peregrine-developments/STACY/README.md

# STACY
Requires symbols/footprints from [TheBoisCollective global library ](https://github.com/peregrine-developments/TBC_Global)
