peregrine-developments/STACY/mounts/GPS Mount.3mf

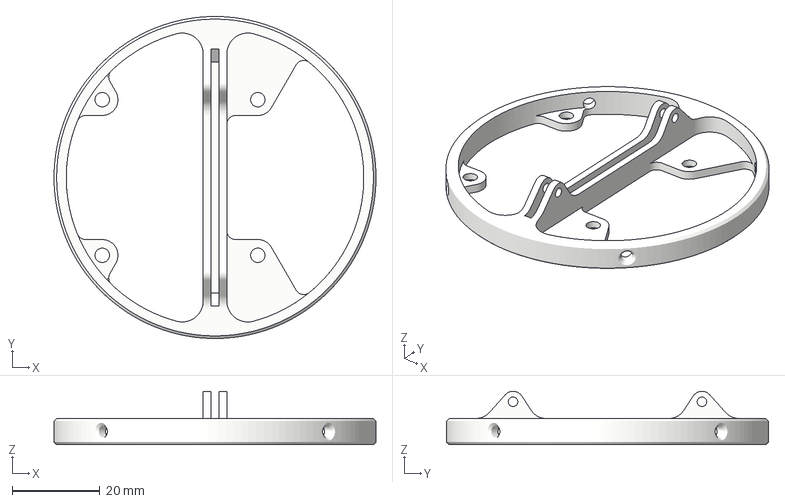
[picture p1: CAD file, 2022-02-06]
mounts/GPS Mount.3mf
73.6 x 73.6 x 12.2 mm
