peregrine-developments/STACY/mounts/Battery Mount.3mf

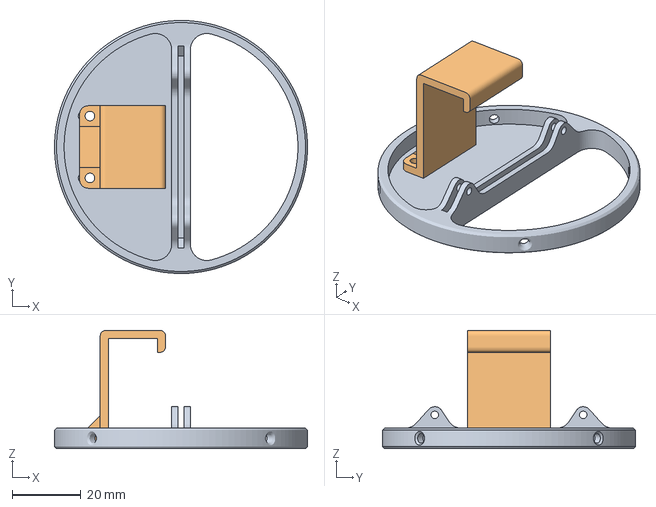
[picture p2: CAD file, 2022-02-06]
mounts/Battery Mount.3mf
73.6 x 73.6 x 34.4 mm
