peregrine-developments/STACY/mounts/Base Mount.3mf

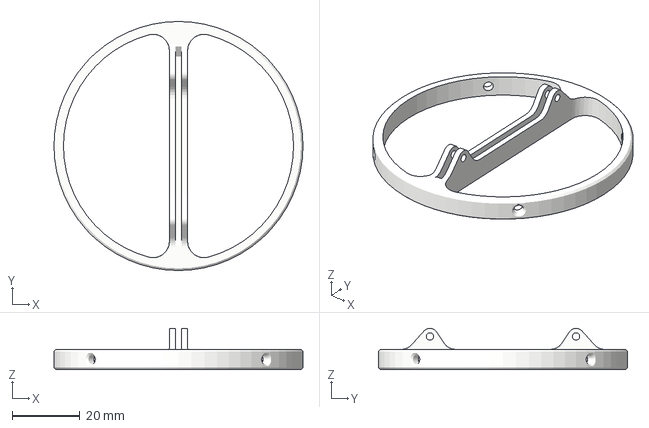
[picture p3: CAD file, 2022-02-06]
mounts/Base Mount.3mf
73.6 x 73.6 x 12.2 mm
