peregrine-developments/STACY/mounts/Bulkhead Mount.3mf

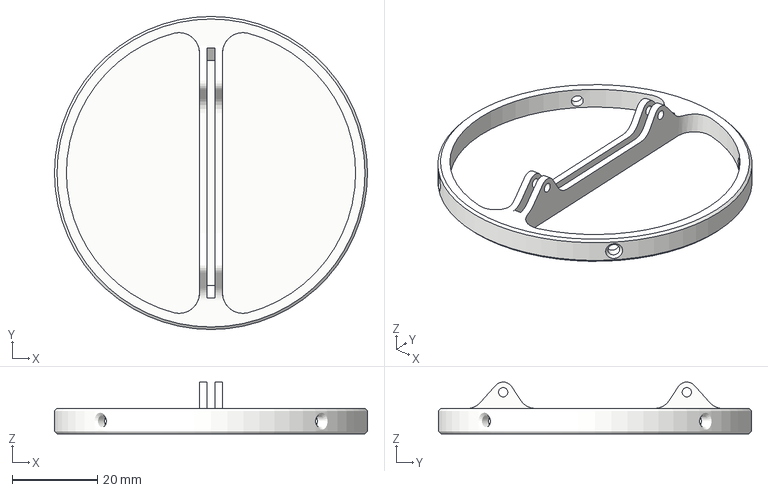
[picture p4: CAD file, 2022-02-06]
mounts/Bulkhead Mount.3mf
73.6 x 73.6 x 12.2 mm
