peregrine-developments/STACY/allfc/allfc.kicad_pcb

## KiCad design allfc/allfc.kicad_pcb (2021-08-03)

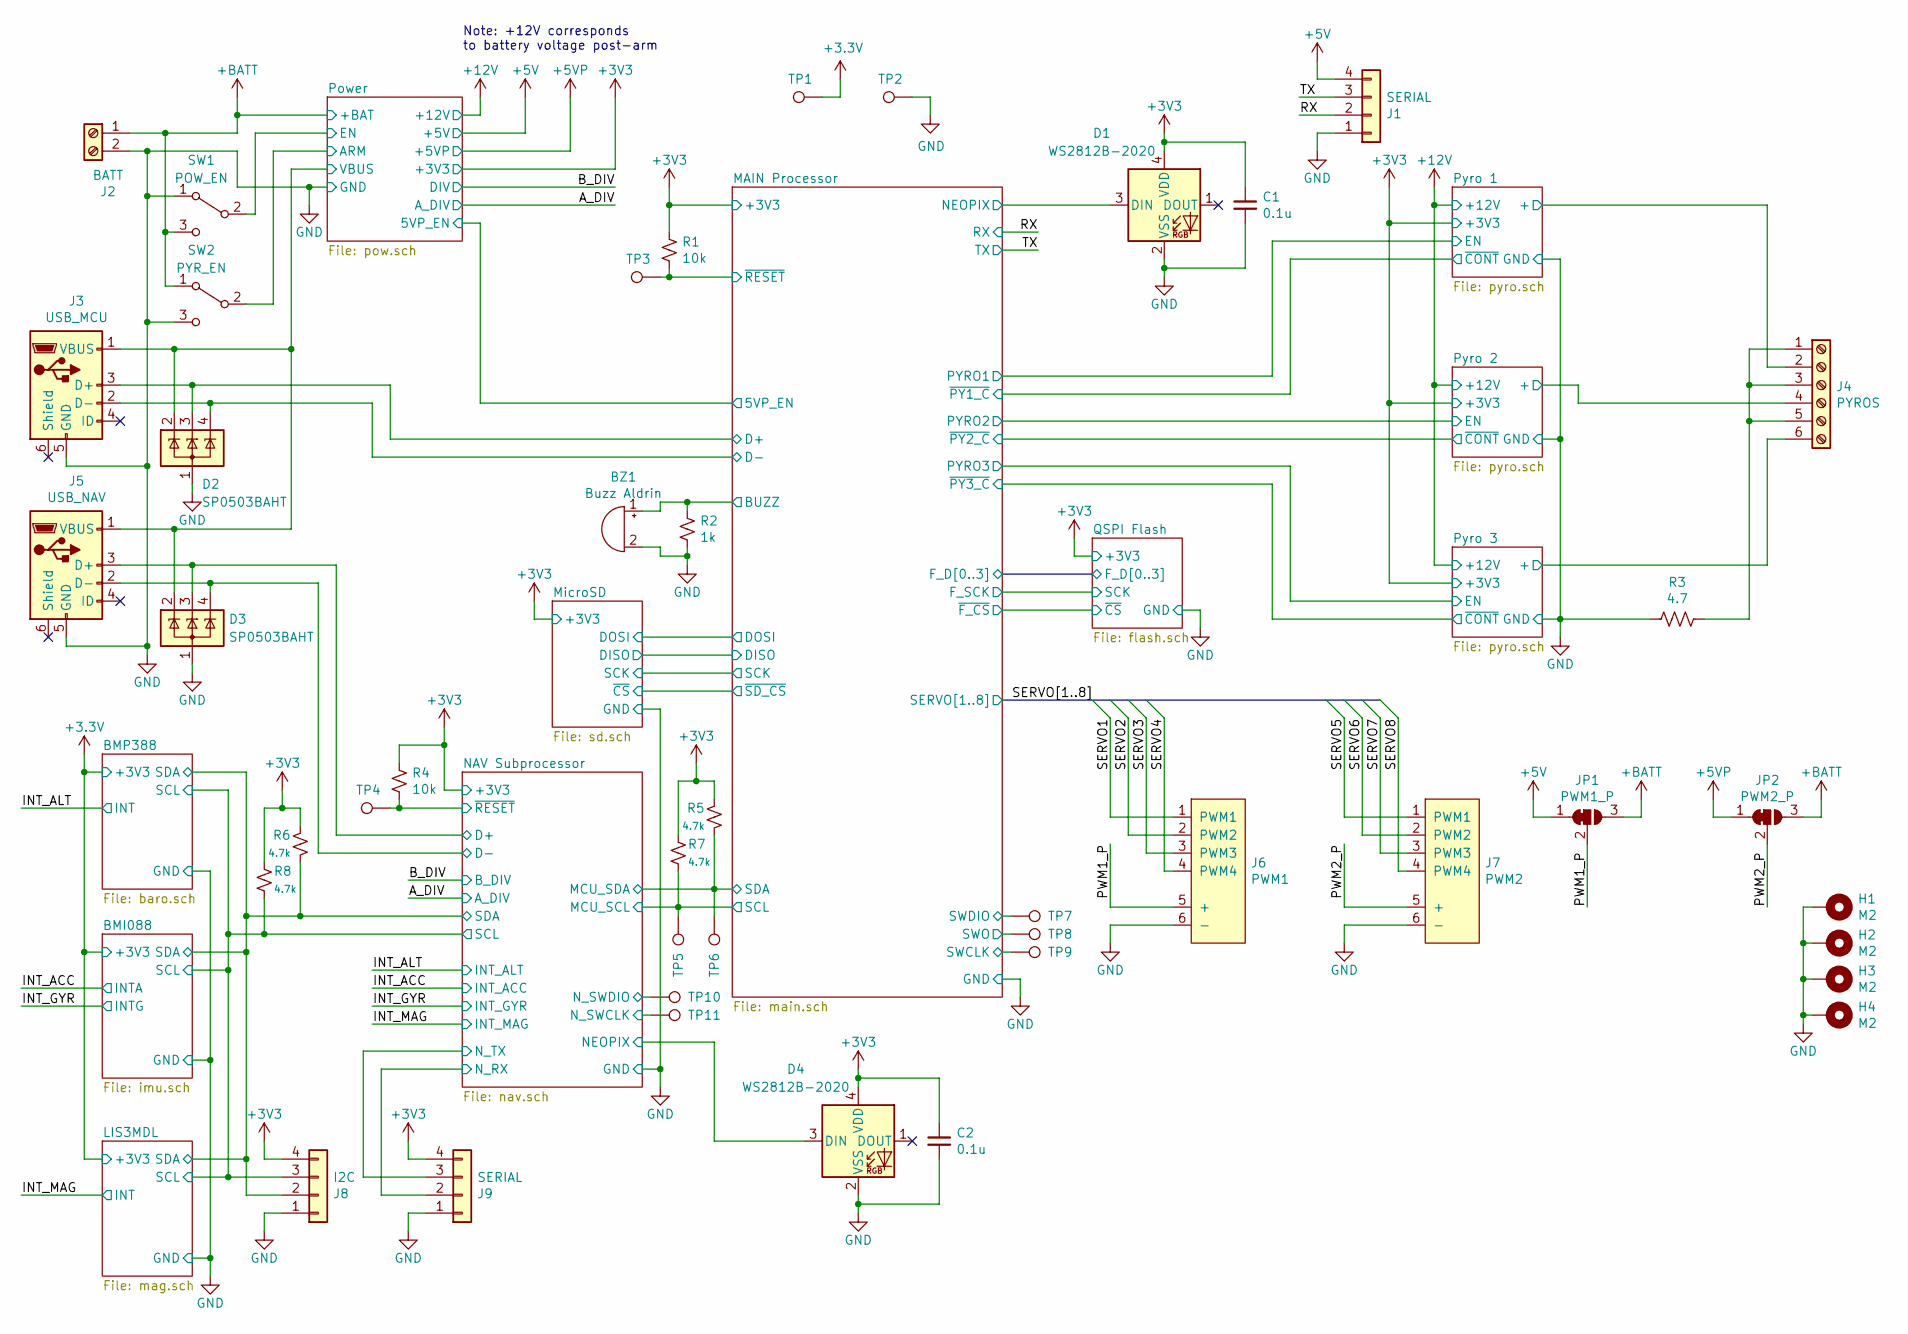
[picture p50: schematic allfc.sch, CUC - Overview]

Parts:
BZ1: Buzz Aldrin; Buzzer_CUI_CPT-9019S-SMT
C1, C2: 0.1u; C_0603_1608Metric
D1, D4: WS2812B-2020; WS2812B-2020_2x2mm
D2, D3: SP0503BAHT; SOT-143
H1, H2, H3, H4: M2; MountingHole_2.2mm_M2_Pad
J1, J9: SERIAL; JST_GH_BM04B-GHS-TBT_1x04-1MP_P1.25mm_Vertical
J2: BATT; TerminalBlock_Phoenix_MKDS-3-2-5.08_1x02_P5.08mm_Horizontal
J3: USB_MCU; USB_Micro-B_Molex_47346-0001_ShieldFloat
J4: PYROS; TerminalBlock_Phoenix_MKDS-3-6-5.08_1x06_P5.08mm_Horizontal
J5: USB_NAV; USB_Micro-B_Molex_47346-0001_ShieldFloat
J6: PWM1; PinHeader_3x04_P2.54mm_Vertical
J7: PWM2; PinHeader_3x04_P2.54mm_Vertical
J8: I2C; JST_GH_BM04B-GHS-TBT_1x04-1MP_P1.25mm_Vertical
JP1: PWM1_P; SolderJumper-3_P1.3mm_Bridged12_Pad1.0x1.5mm_NumberLabels
JP2: PWM2_P; SolderJumper-3_P1.3mm_Bridged12_Pad1.0x1.5mm_NumberLabels
R1, R4: 10k; R_0603_1608Metric
R2: 1k; R_0603_1608Metric
R3: 4.7; R_2512_6332Metric
R5, R6, R7, R8: 4.7k; R_0603_1608Metric
SW1: POW_EN; SW_SPDT_PCM12_HIDD
SW2: PYR_EN; SW_SPDT_PCM12_HIDD
TP1, TP2, TP3, TP4, TP5, TP6, TP7, TP8, TP9, TP10, TP11: TestPoint; TestPoint_THTPad_D1.0mm_Drill0.5mm

Connections:
+3V3: C1.1, C2.1, D1.4 (VDD), D4.4 (VDD), J8.4, J9.4, R1.2, R4.2, R5.1, R6.1, R7.1, R8.1, TP1.1; also elsewhere on the board
+5V: J1.4, JP1.1 (A); also elsewhere on the board
+5VP: JP2.1 (A); also elsewhere on the board
+BATT: J2.1, JP1.3 (B), JP2.3 (B), SW1.3 (C), SW2.1 (A); also elsewhere on the board
/BMI088/SCL: J8.3, R8.2; also elsewhere on the board
/BMI088/SDA: J8.2, R6.2; also elsewhere on the board
/MAIN Processor/BUZZ: BZ1.1 (-), R2.1; also elsewhere on the board
/MAIN Processor/D+: D2.3 (K), J3.3 (D+); also elsewhere on the board
/MAIN Processor/D-: D2.4 (K), J3.2 (D-); also elsewhere on the board
/MAIN Processor/NEOPIX: D1.3 (DIN); also elsewhere on the board
/MAIN Processor/SWCLK: TP9.1; also elsewhere on the board
/MAIN Processor/SWDIO: TP7.1; also elsewhere on the board
/MAIN Processor/SWO: TP8.1; also elsewhere on the board
/MAIN Processor/~RESET: R1.1, TP3.1; also elsewhere on the board
/NAV Subprocessor/D+: D3.3 (K), J5.3 (D+); also elsewhere on the board
/NAV Subprocessor/D-: D3.4 (K), J5.2 (D-); also elsewhere on the board
/NAV Subprocessor/MCU_SCL: R7.2, TP5.1; also elsewhere on the board
/NAV Subprocessor/MCU_SDA: R5.2, TP6.1; also elsewhere on the board
/NAV Subprocessor/NEOPIX: D4.3 (DIN); also elsewhere on the board
/NAV Subprocessor/N_RX: J9.2; also elsewhere on the board
/NAV Subprocessor/N_SWCLK: TP11.1; also elsewhere on the board
/NAV Subprocessor/N_SWDIO: TP10.1; also elsewhere on the board
/NAV Subprocessor/N_TX: J9.3; also elsewhere on the board
/NAV Subprocessor/~RESET: R4.1, TP4.1; also elsewhere on the board
/PWM1_P: J6.5 (+), JP1.2 (C)
/PWM2_P: J7.5 (+), JP2.2 (C)
/Power/ARM: SW2.2 (B); also elsewhere on the board
/Power/EN: SW1.2 (B); also elsewhere on the board
/Power/VBUS: D2.2 (K), D3.2 (K), J3.1 (VBUS), J5.1 (VBUS); also elsewhere on the board
/Pyro 1/+: J4.2; also elsewhere on the board
/Pyro 2/+: J4.4; also elsewhere on the board
/Pyro 3/+: J4.6; also elsewhere on the board
/RX: J1.2; also elsewhere on the board
/SERVO1: J6.1 (PWM1); also elsewhere on the board
/SERVO2: J6.2 (PWM2); also elsewhere on the board
/SERVO3: J6.3 (PWM3); also elsewhere on the board
/SERVO4: J6.4 (PWM4); also elsewhere on the board
/SERVO5: J7.1 (PWM1); also elsewhere on the board
/SERVO6: J7.2 (PWM2); also elsewhere on the board
/SERVO7: J7.3 (PWM3); also elsewhere on the board
/SERVO8: J7.4 (PWM4); also elsewhere on the board
/TX: J1.3; also elsewhere on the board
GND: BZ1.2 (+), C1.2, C2.2, D1.2 (VSS), D2.1 (A), D3.1 (A), D4.2 (VSS), H1.1, H2.1, H3.1, H4.1, J1.1, J2.2, J3.5 (GND), J5.5 (GND), J6.6 (-), J7.6 (-), J8.1, J9.1, R2.2, R3.2, SW1.1 (A), SW2.3 (C), TP2.1; also elsewhere on the board
unnamed: J4.1, J4.3, J4.5, R3.1

Notes on the sheet:
Note: +12V corresponds to battery voltage post-arm

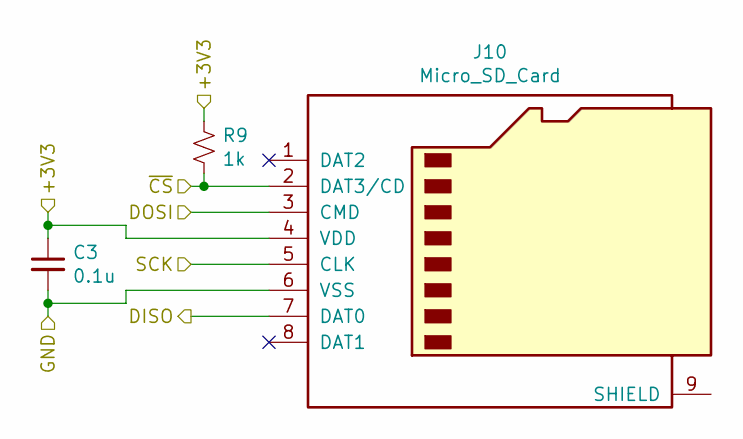
[picture p51: schematic sd.sch, CUC - MicroSD]

Parts:
C3: 0.1u; C_0603_1608Metric
J10: Micro_SD_Card; microSD_HC_Hirose_DM3D-SF
R9: 1k; R_0603_1608Metric

Connections:
+3V3: C3.1, J10.4 (VDD), R9.1; also elsewhere on the board
/MAIN Processor/DISO: J10.7 (DAT0); also elsewhere on the board
/MAIN Processor/DOSI: J10.3 (CMD); also elsewhere on the board
/MAIN Processor/SCK: J10.5 (CLK); also elsewhere on the board
/MicroSD/~CS: J10.2 (DAT3/CD), R9.2; also elsewhere on the board
GND: C3.2, J10.6 (VSS); also elsewhere on the board

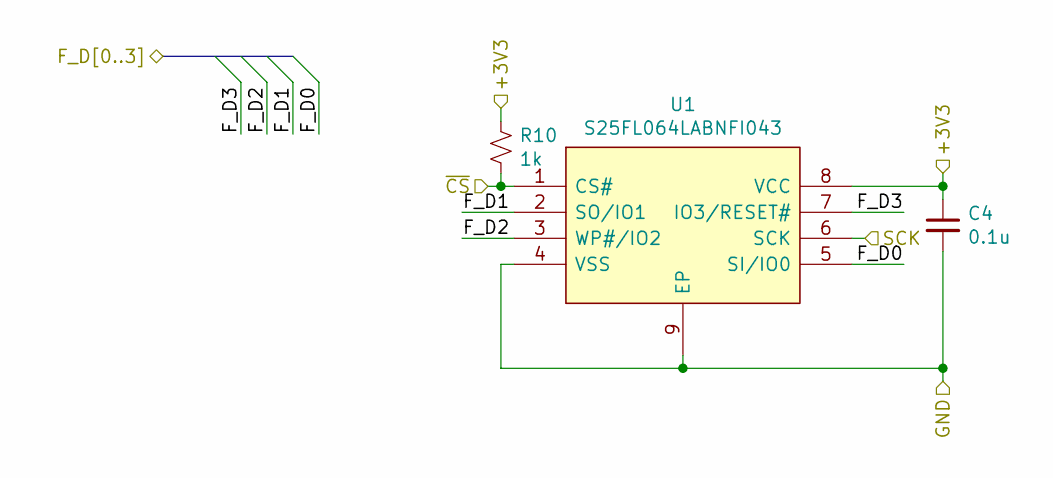
[picture p52: schematic flash.sch, CUC - Onboard Flash]

Parts:
C4: 0.1u; C_0603_1608Metric
R10: 1k; R_0603_1608Metric
U1: S25FL064LABNFI043; SON80P400X400X60-9N; Mouser Part Number 727-S25FL064LABNF043

Connections:
+3V3: C4.1, R10.1, U1.8 (VCC); also elsewhere on the board
/MAIN Processor/F_D0: U1.5 (SI/IO0); also elsewhere on the board
/MAIN Processor/F_D1: U1.2 (SO/IO1); also elsewhere on the board
/MAIN Processor/F_D2: U1.3 (WP#/IO2); also elsewhere on the board
/MAIN Processor/F_D3: U1.7 (IO3/RESET#); also elsewhere on the board
/MAIN Processor/F_SCK: U1.6 (SCK); also elsewhere on the board
/QSPI Flash/~CS: R10.2, U1.1 (CS#); also elsewhere on the board
GND: C4.2, U1.4 (VSS), U1.9 (EP); also elsewhere on the board

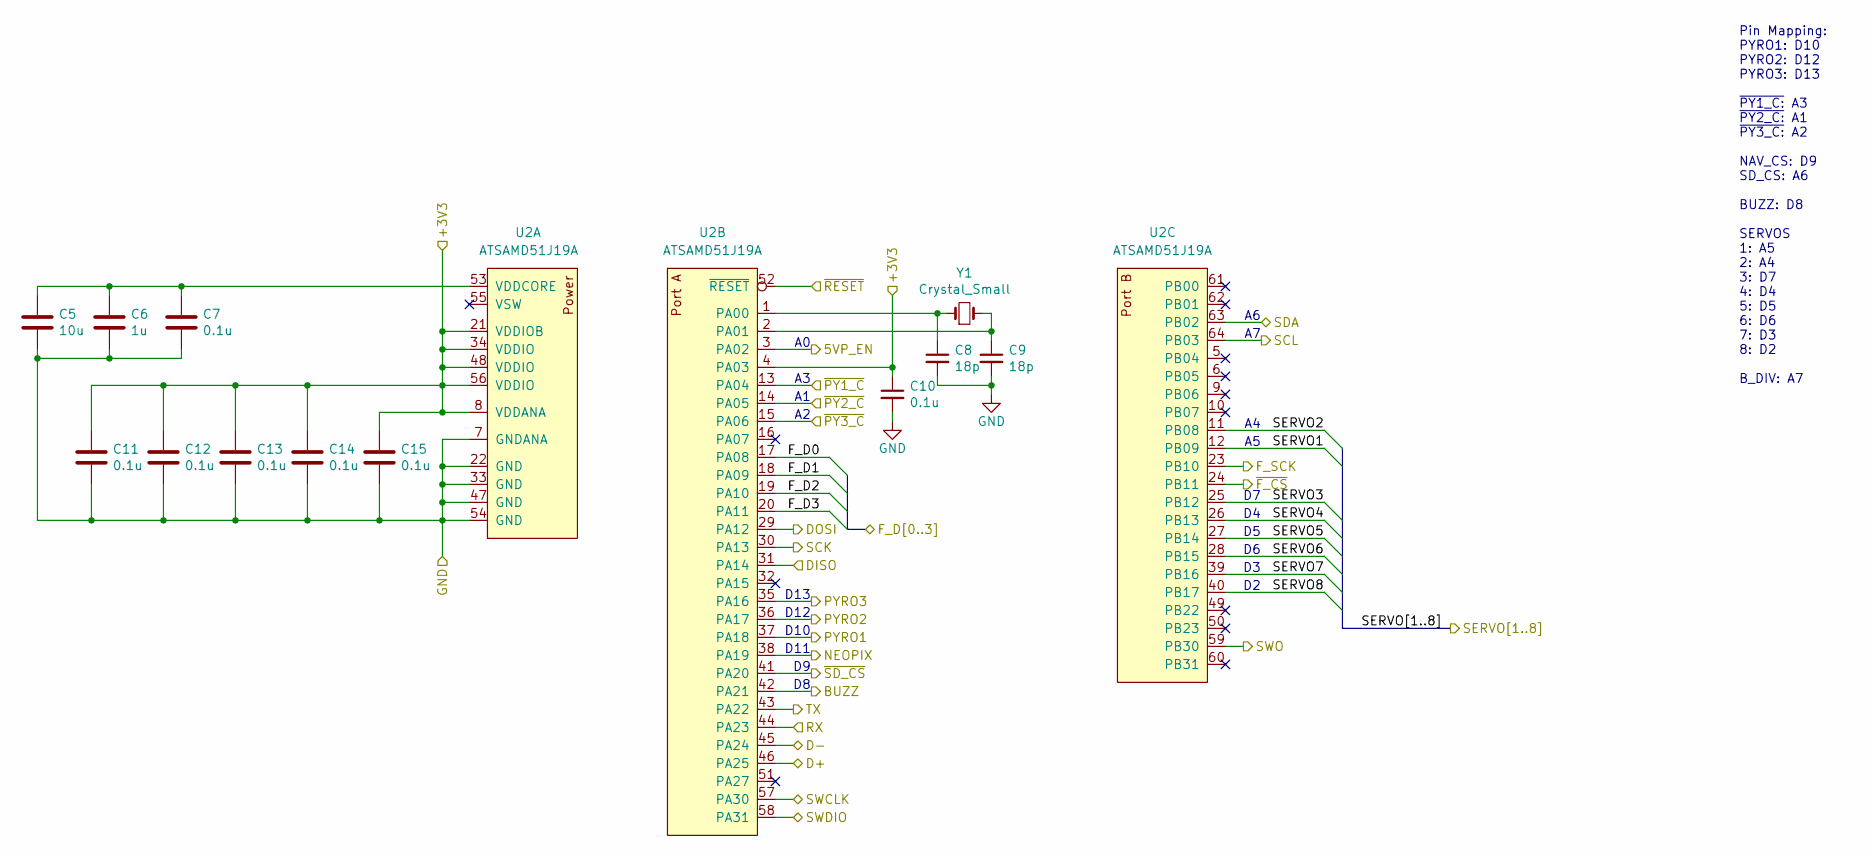
[picture p53: schematic main.sch, CUC - Main Processor]

Parts:
C5: 10u; C_0603_1608Metric
C6: 1u; C_0603_1608Metric
C7, C10, C11, C12, C13, C14, C15: 0.1u; C_0603_1608Metric
C8, C9: 18p; C_0402_1005Metric
U2: ATSAMD51J19A; QFN-64-1EP_9x9mm_P0.5mm_EP4.7x4.7mm
Y1: Crystal_Small; Crystal_SMD_2012-2Pin_2.0x1.2mm

Connections:
+3V3: C10.1, C11.1, C12.1, C13.1, C14.1, C15.1, U2.4 (PA03), U2.8 (VDDANA), U2.21 (VDDIOB), U2.34 (VDDIO), U2.48 (VDDIO), U2.56 (VDDIO); also elsewhere on the board
/MAIN Processor/5VP_EN: U2.3 (PA02); also elsewhere on the board
/MAIN Processor/BUZZ: U2.42 (PA21); also elsewhere on the board
/MAIN Processor/D+: U2.46 (PA25); also elsewhere on the board
/MAIN Processor/D-: U2.45 (PA24); also elsewhere on the board
/MAIN Processor/DISO: U2.31 (PA14); also elsewhere on the board
/MAIN Processor/DOSI: U2.29 (PA12); also elsewhere on the board
/MAIN Processor/F_D0: U2.17 (PA08); also elsewhere on the board
/MAIN Processor/F_D1: U2.18 (PA09); also elsewhere on the board
/MAIN Processor/F_D2: U2.19 (PA10); also elsewhere on the board
/MAIN Processor/F_D3: U2.20 (PA11); also elsewhere on the board
/MAIN Processor/F_SCK: U2.23 (PB10); also elsewhere on the board
/MAIN Processor/NEOPIX: U2.38 (PA19); also elsewhere on the board
/MAIN Processor/SCK: U2.30 (PA13); also elsewhere on the board
/MAIN Processor/SWCLK: U2.57 (PA30); also elsewhere on the board
/MAIN Processor/SWDIO: U2.58 (PA31); also elsewhere on the board
/MAIN Processor/SWO: U2.59 (PB30); also elsewhere on the board
/MAIN Processor/~RESET: U2.52 (~RESET); also elsewhere on the board
/MicroSD/~CS: U2.41 (PA20); also elsewhere on the board
/NAV Subprocessor/MCU_SCL: U2.64 (PB03); also elsewhere on the board
/NAV Subprocessor/MCU_SDA: U2.63 (PB02); also elsewhere on the board
/Pyro 1/EN: U2.37 (PA18); also elsewhere on the board
/Pyro 1/~CONT: U2.13 (PA04); also elsewhere on the board
/Pyro 2/EN: U2.36 (PA17); also elsewhere on the board
/Pyro 2/~CONT: U2.14 (PA05); also elsewhere on the board
/Pyro 3/EN: U2.35 (PA16); also elsewhere on the board
/Pyro 3/~CONT: U2.15 (PA06); also elsewhere on the board
/QSPI Flash/~CS: U2.24 (PB11); also elsewhere on the board
/RX: U2.44 (PA23); also elsewhere on the board
/SERVO1: U2.12 (PB09); also elsewhere on the board
/SERVO2: U2.11 (PB08); also elsewhere on the board
/SERVO3: U2.25 (PB12); also elsewhere on the board
/SERVO4: U2.26 (PB13); also elsewhere on the board
/SERVO5: U2.27 (PB14); also elsewhere on the board
/SERVO6: U2.28 (PB15); also elsewhere on the board
/SERVO7: U2.39 (PB16); also elsewhere on the board
/SERVO8: U2.40 (PB17); also elsewhere on the board
/TX: U2.43 (PA22); also elsewhere on the board
GND: C5.2, C6.2, C7.2, C8.2, C9.2, C10.2, C11.2, C12.2, C13.2, C14.2, C15.2, U2.7 (GNDANA), U2.22 (GND), U2.33 (GND), U2.47 (GND), U2.54 (GND); also elsewhere on the board
unnamed: C5.1, C6.1, C7.1, U2.53 (VDDCORE)
unnamed: C8.1, U2.1 (PA00), Y1.1
unnamed: C9.1, U2.2 (PA01), Y1.2

Notes on the sheet:
Pin Mapping: PYRO1: D10 PYRO2: D12 PYRO3: D13 ~PY1_C:~ A3 ~PY2_C:~ A1 ~PY3_C:~ A2 NAV_CS: D9 SD_CS: A6 BUZZ: D8 SERVOS 1: A5 2: A4 3: D7 4: D4 5: D5 6: D6 7: D3 8: D2 B_DIV: A7
D11
D10
D12
D13

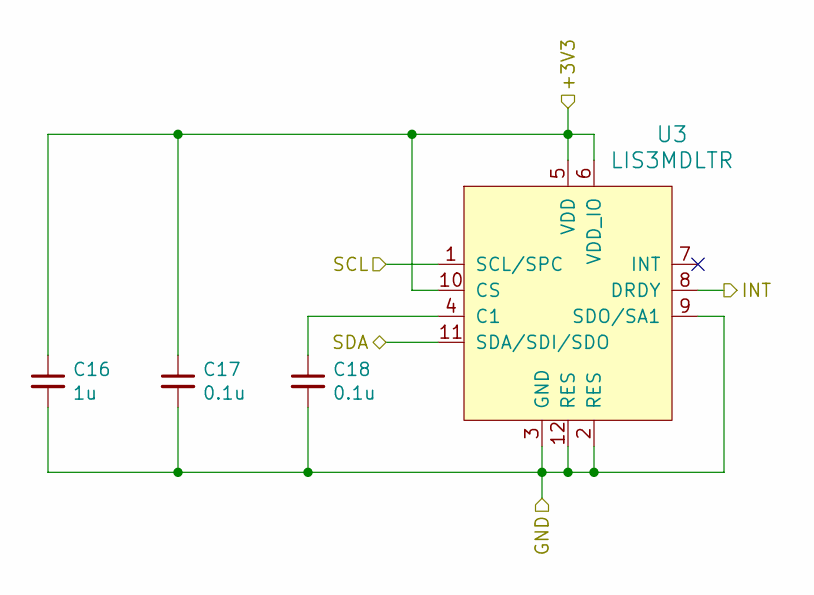
[picture p54: schematic mag.sch, CUC - Magnetometer]

Parts:
C16: 1u; C_0603_1608Metric
C17, C18: 0.1u; C_0603_1608Metric
U3: LIS3MDLTR; VFLGA-12_2x2mm; MPN LIS3MDLTR; Digi-Key_PN 497-13892-1-ND

Connections:
+3V3: C16.1, C17.1, U3.5 (VDD), U3.6 (VDD_IO), U3.10 (CS); also elsewhere on the board
/BMI088/SCL: U3.1 (SCL/SPC); also elsewhere on the board
/BMI088/SDA: U3.11 (SDA/SDI/SDO); also elsewhere on the board
/INT_MAG: U3.8 (DRDY); also elsewhere on the board
GND: C16.2, C17.2, C18.2, U3.2 (RES), U3.3 (GND), U3.9 (SDO/SA1), U3.12 (RES); also elsewhere on the board
unnamed: C18.1, U3.4 (C1)

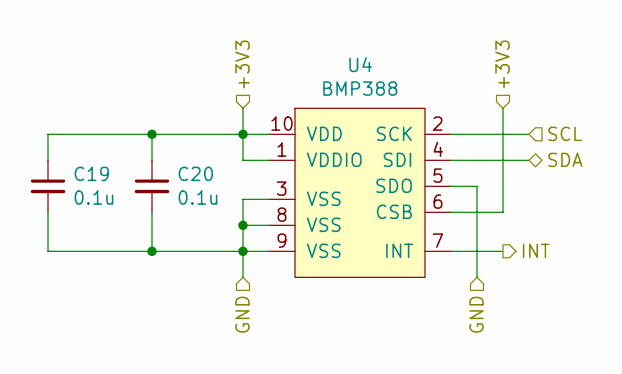
[picture p55: schematic baro.sch, CUC - Altimeter]

Parts:
C19, C20: 0.1u; C_0603_1608Metric
U4: BMP388

Connections:
+3V3: C19.1, C20.1, U4.1 (VDDIO), U4.6 (CSB), U4.10 (VDD); also elsewhere on the board
/BMI088/SCL: U4.2 (SCK); also elsewhere on the board
/BMI088/SDA: U4.4 (SDI); also elsewhere on the board
/INT_ALT: U4.7 (INT); also elsewhere on the board
GND: C19.2, C20.2, U4.3 (VSS), U4.5 (SDO), U4.8 (VSS), U4.9 (VSS); also elsewhere on the board

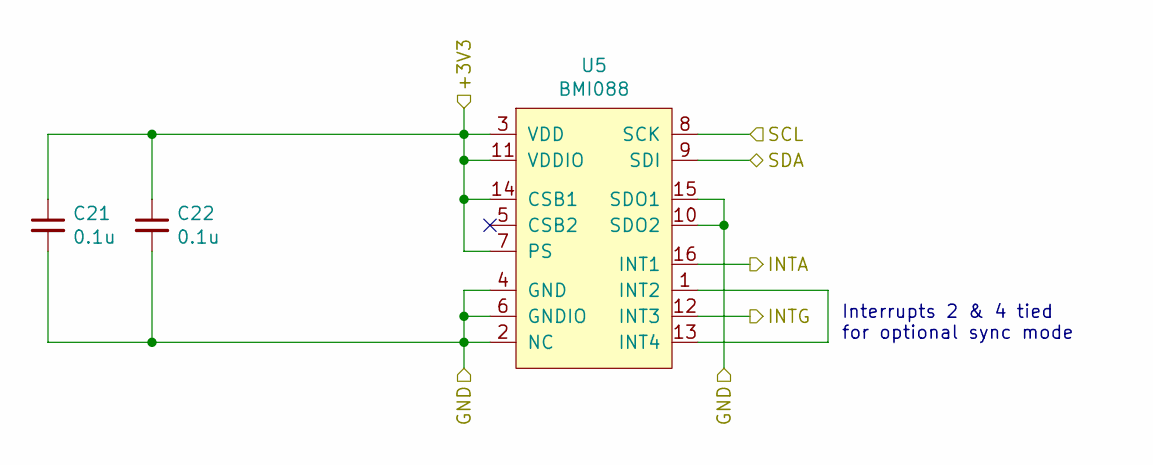
[picture p56: schematic imu.sch, CUC - IMU]

Parts:
C21, C22: 0.1u; C_0603_1608Metric
U5: BMI088; VQFN16_4.5x3.0mm

Connections:
+3V3: C21.1, C22.1, U5.3 (VDD), U5.7 (PS), U5.11 (VDDIO), U5.14 (CSB1); also elsewhere on the board
/BMI088/SCL: U5.8 (SCK); also elsewhere on the board
/BMI088/SDA: U5.9 (SDI); also elsewhere on the board
/INT_ACC: U5.16 (INT1); also elsewhere on the board
/INT_GYR: U5.12 (INT3); also elsewhere on the board
GND: C21.2, C22.2, U5.2 (NC), U5.4 (GND), U5.6 (GNDIO), U5.10 (SDO2), U5.15 (SDO1); also elsewhere on the board
unnamed: U5.1 (INT2), U5.13 (INT4)

Notes on the sheet:
Interrupts 2 & 4 tied for optional sync mode

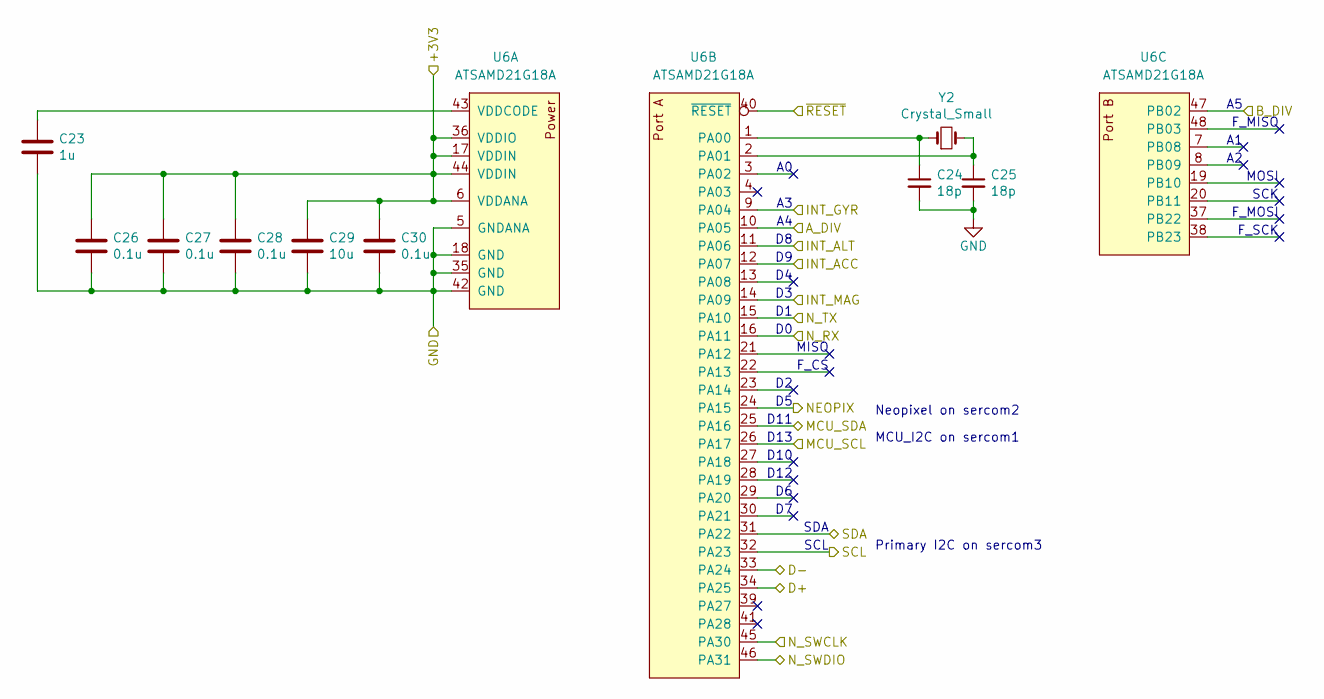
[picture p57: schematic nav.sch, CUC - NAV Processor]

Parts:
C23: 1u; C_0603_1608Metric
C24, C25: 18p; C_0402_1005Metric
C26, C27, C28, C30: 0.1u; C_0603_1608Metric
C29: 10u; C_0603_1608Metric
U6: ATSAMD21G18A; VQFN-48-1EP_7x7mm_P0.5mm_EP5.15x5.15mm
Y2: Crystal_Small; Crystal_SMD_2012-2Pin_2.0x1.2mm

Connections:
+3V3: C26.1, C27.1, C28.1, C29.1, C30.1, U6.6 (VDDANA), U6.17 (VDDIN), U6.36 (VDDIO), U6.44 (VDDIN); also elsewhere on the board
/A_DIV: U6.10 (PA05); also elsewhere on the board
/BMI088/SCL: U6.32 (PA23); also elsewhere on the board
/BMI088/SDA: U6.31 (PA22); also elsewhere on the board
/B_DIV: U6.47 (PB02); also elsewhere on the board
/INT_ACC: U6.12 (PA07); also elsewhere on the board
/INT_ALT: U6.11 (PA06); also elsewhere on the board
/INT_GYR: U6.9 (PA04); also elsewhere on the board
/INT_MAG: U6.14 (PA09); also elsewhere on the board
/NAV Subprocessor/D+: U6.34 (PA25); also elsewhere on the board
/NAV Subprocessor/D-: U6.33 (PA24); also elsewhere on the board
/NAV Subprocessor/MCU_SCL: U6.26 (PA17); also elsewhere on the board
/NAV Subprocessor/MCU_SDA: U6.25 (PA16); also elsewhere on the board
/NAV Subprocessor/NEOPIX: U6.24 (PA15); also elsewhere on the board
/NAV Subprocessor/N_RX: U6.16 (PA11); also elsewhere on the board
/NAV Subprocessor/N_SWCLK: U6.45 (PA30); also elsewhere on the board
/NAV Subprocessor/N_SWDIO: U6.46 (PA31); also elsewhere on the board
/NAV Subprocessor/N_TX: U6.15 (PA10); also elsewhere on the board
/NAV Subprocessor/~RESET: U6.40 (~RESET); also elsewhere on the board
GND: C23.2, C24.2, C25.2, C26.2, C27.2, C28.2, C29.2, C30.2, U6.5 (GNDANA), U6.18 (GND), U6.35 (GND), U6.42 (GND); also elsewhere on the board
unnamed: C23.1, U6.43 (VDDCODE)
unnamed: C24.1, U6.1 (PA00), Y2.1
unnamed: C25.1, U6.2 (PA01), Y2.2

Notes on the sheet:
Primary I2C on sercom3
MISO
F_CS
D11
D13
D10
SDA
SCL
F_MISO
MOSI
SCK
F_MOSI
F_SCK
D12
MCU_I2C on sercom1
Neopixel on sercom2

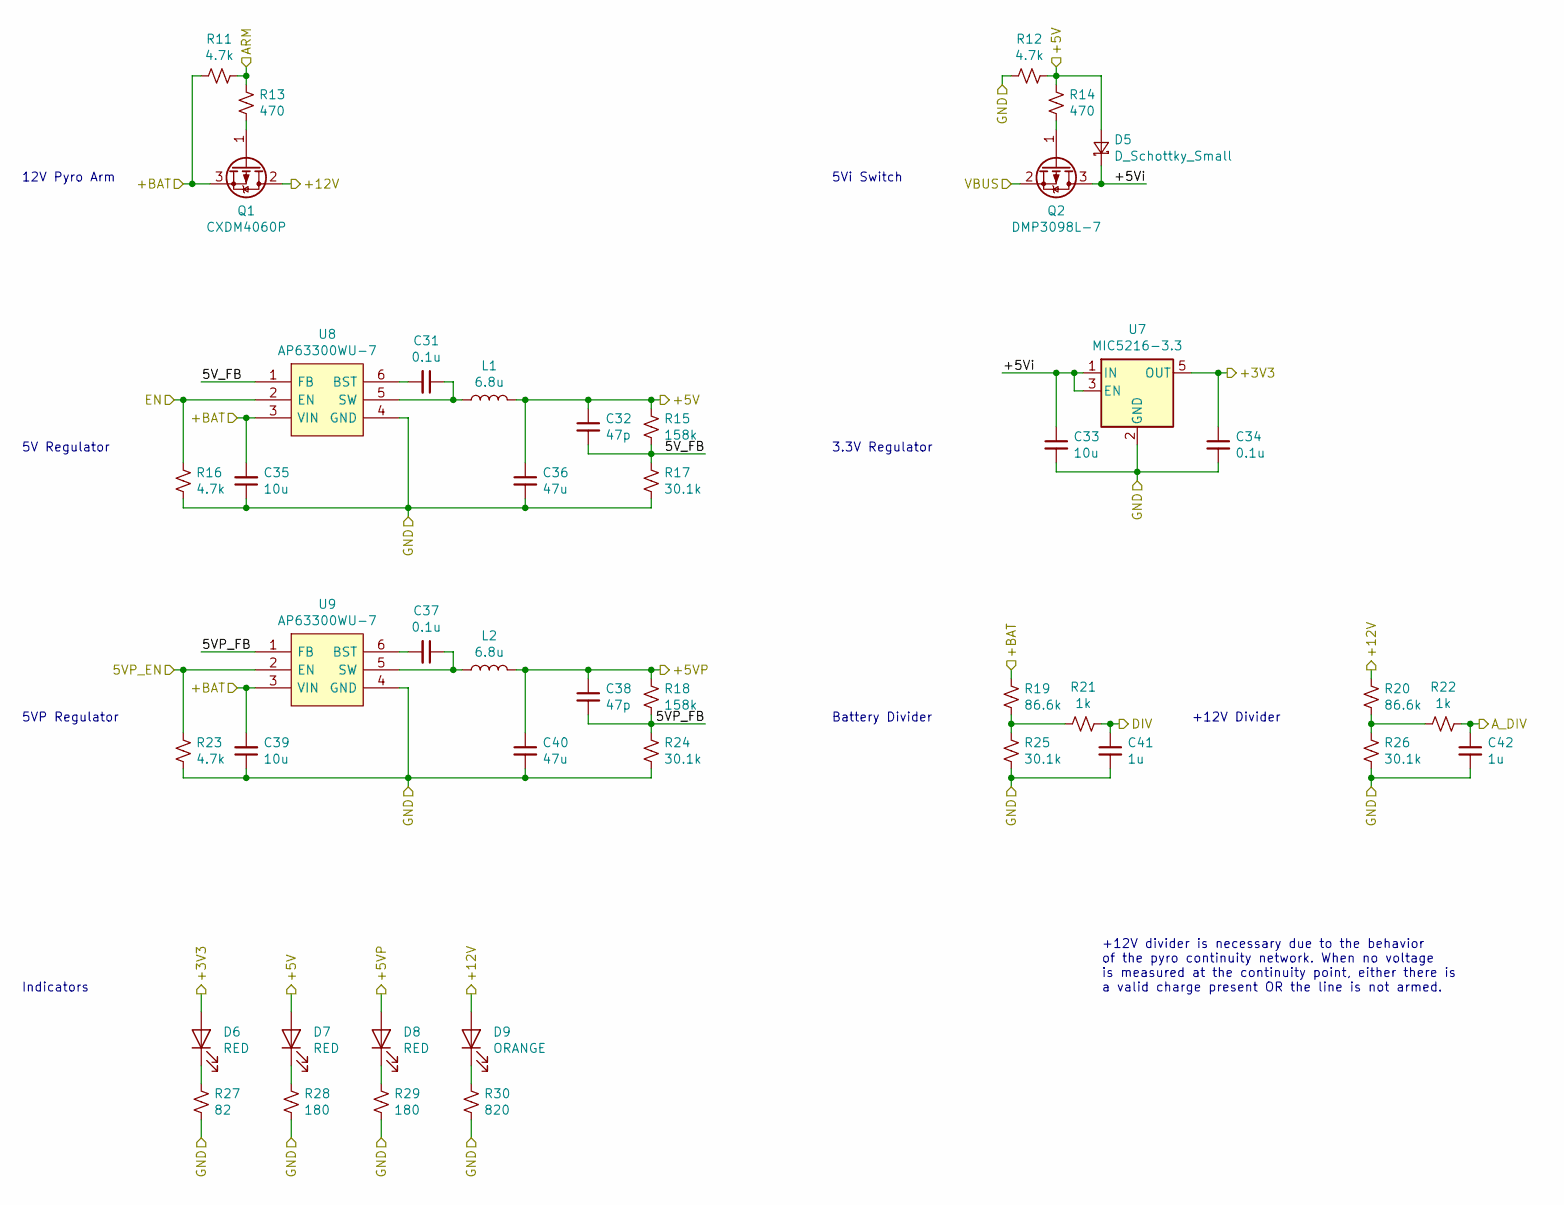
[picture p58: schematic pow.sch, CUC - Power Domain]

Parts:
C31, C34, C37: 0.1u; C_0603_1608Metric
C32, C38: 47p; C_0603_1608Metric
C33, C35, C39: 10u; C_0603_1608Metric
C36, C40: 47u; C_0805_2012Metric
C41, C42: 1u; C_0603_1608Metric
D5: D_Schottky_Small; D_SOD-323
D6, D7, D8: RED; LED_0603_1608Metric
D9: ORANGE; LED_0603_1608Metric
L1, L2: 6.8u; L_Bourns_SRP7028A_7.3x6.6mm
Q1: CXDM4060P; SOT-89-3
Q2: DMP3098L-7; SOT-23
R11, R12, R16, R23: 4.7k; R_0603_1608Metric
R13, R14: 470; R_0603_1608Metric
R15, R18: 158k; R_0603_1608Metric
R17, R24, R25, R26: 30.1k; R_0603_1608Metric
R19, R20: 86.6k; R_0603_1608Metric
R21, R22: 1k; R_0603_1608Metric
R27: 82; R_0603_1608Metric
R28, R29: 180; R_0603_1608Metric
R30: 820; R_0603_1608Metric
U7: ‎MIC5216-3.3; SOT-23-5
U8, U9: AP63300WU-7; SOT95P280X90-6N; Mouser Part Number 621-AP63300WU-7

Connections:
+3V3: C34.1, D6.2 (A), U7.5 (OUT); also elsewhere on the board
+5V: C32.1, C36.1, D5.2 (A), D7.2 (A), L1.2, R12.1, R14.1, R15.1; also elsewhere on the board
+5VP: C38.1, C40.1, D8.2 (A), L2.2, R18.1; also elsewhere on the board
+12V: D9.2 (A), Q1.2 (D), R20.1; also elsewhere on the board
+BATT: C35.2, C39.2, Q1.3 (S), R11.2, R19.1, U8.3 (VIN), U9.3 (VIN); also elsewhere on the board
/A_DIV: C42.1, R22.1; also elsewhere on the board
/B_DIV: C41.1, R21.1; also elsewhere on the board
/MAIN Processor/5VP_EN: R23.1, U9.2 (EN); also elsewhere on the board
/Power/5VP_FB: C38.2, R18.2, R24.1, U9.1 (FB)
/Power/5V_FB: C32.2, R15.2, R17.1, U8.1 (FB)
/Power/+5Vi: C33.1, D5.1 (K), Q2.3 (D), U7.1 (IN), U7.3 (EN)
/Power/ARM: R11.1, R13.1; also elsewhere on the board
/Power/EN: R16.1, U8.2 (EN); also elsewhere on the board
/Power/VBUS: Q2.2 (S); also elsewhere on the board
GND: C33.2, C34.2, C35.1, C36.2, C39.1, C40.2, C41.2, C42.2, R12.2, R16.2, R17.2, R23.2, R24.2, R25.2, R26.2, R27.2, R28.2, R29.2, R30.2, U7.2 (GND), U8.4 (GND), U9.4 (GND); also elsewhere on the board
unnamed: C31.1, L1.1, U8.5 (SW)
unnamed: C31.2, U8.6 (BST)
unnamed: C37.1, L2.1, U9.5 (SW)
unnamed: C37.2, U9.6 (BST)
unnamed: D6.1 (K), R27.1
unnamed: D7.1 (K), R28.1
unnamed: D8.1 (K), R29.1
unnamed: D9.1 (K), R30.1
unnamed: Q1.1 (G), R13.2
unnamed: Q2.1 (G), R14.2
unnamed: R19.2, R21.2, R25.1
unnamed: R20.2, R22.2, R26.1

Notes on the sheet:
5V Regulator
5VP Regulator
12V Pyro Arm
3.3V Regulator
Battery Divider
5Vi Switch
Indicators
+12V Divider
+12V divider is necessary due to the behavior of the pyro continuity network. When no voltage is measured at the continuity point, either there is a valid charge present OR the line is not armed.

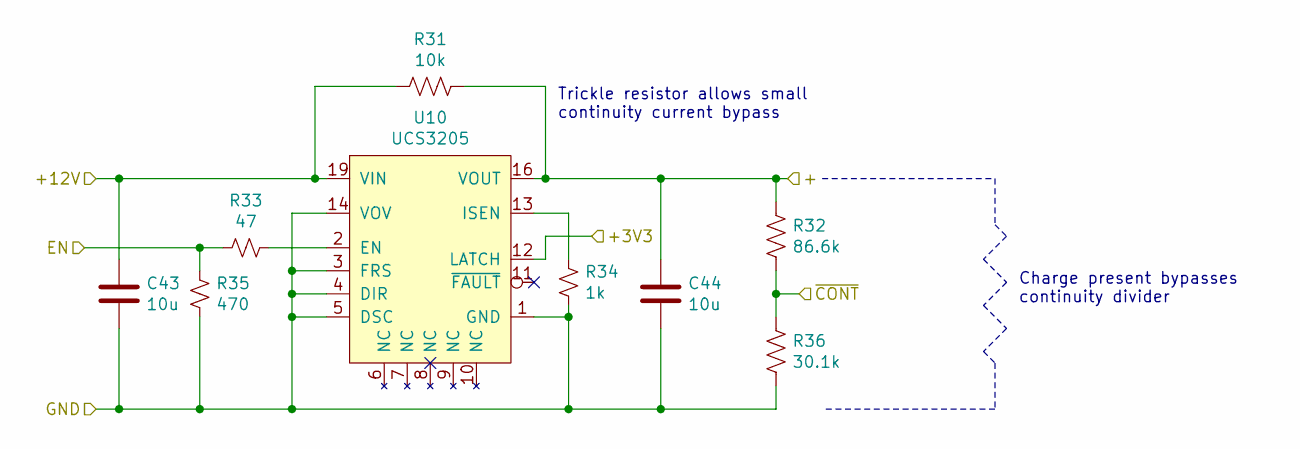
[picture p59: schematic pyro.sch, CUC - Pyro Channel]

Parts:
C43, C44: 10u; C_0603_1608Metric
R31: 10k; R_0603_1608Metric
R32: 86.6k; R_0603_1608Metric
R33: 47; R_0603_1608Metric
R34: 1k; R_0603_1608Metric
R35: 470; R_0603_1608Metric
R36: 30.1k; R_0603_1608Metric
U10: UCS3205; VQFN19_3.0x3.0mm_2EP

Connections:
+3V3: U10.12 (LATCH); also elsewhere on the board
+12V: C43.1, R31.2, U10.19 (VIN), U10.20 (VOUT), U10.22 (VIN); also elsewhere on the board
/Pyro 1/+: C44.1, R31.1, R32.1, U10.16 (VOUT), U10.17 (VOUT), U10.21 (VOUT); also elsewhere on the board
/Pyro 1/EN: R33.2, R35.1; also elsewhere on the board
/Pyro 1/~CONT: R32.2, R36.1; also elsewhere on the board
GND: C43.2, C44.2, R34.2, R35.2, R36.2, U10.1 (GND), U10.3 (FRS), U10.4 (DIR), U10.5 (DSC), U10.14 (VOV), U10.15 (GND); also elsewhere on the board
unnamed: R33.1, U10.2 (EN)
unnamed: R34.1, U10.13 (ISEN)

Parts of its further copies:
C45, C46, C47, C48: 10u; C_0603_1608Metric
R37, R43: 10k; R_0603_1608Metric
R38, R44: 86.6k; R_0603_1608Metric
R39, R45: 47; R_0603_1608Metric
R40, R46: 1k; R_0603_1608Metric
R41, R47: 470; R_0603_1608Metric
R42, R48: 30.1k; R_0603_1608Metric
U11, U12: UCS3205; VQFN19_3.0x3.0mm_2EP

Connections of its further copies:
+3V3: U11.12 (LATCH), U12.12 (LATCH); also elsewhere on the board
+12V: C45.1, C47.1, R37.2, R43.2, U11.19 (VIN), U11.20 (VOUT), U11.22 (VIN), U12.19 (VIN), U12.20 (VOUT), U12.22 (VIN); also elsewhere on the board
/Pyro 2/+: C46.1, R37.1, R38.1, U11.16 (VOUT), U11.17 (VOUT), U11.21 (VOUT); also elsewhere on the board
/Pyro 2/EN: R39.2, R41.1; also elsewhere on the board
/Pyro 2/~CONT: R38.2, R42.1; also elsewhere on the board
/Pyro 3/+: C48.1, R43.1, R44.1, U12.16 (VOUT), U12.17 (VOUT), U12.21 (VOUT); also elsewhere on the board
/Pyro 3/EN: R45.2, R47.1; also elsewhere on the board
/Pyro 3/~CONT: R44.2, R48.1; also elsewhere on the board
GND: C45.2, C46.2, C47.2, C48.2, R40.2, R41.2, R42.2, R46.2, R47.2, R48.2, U11.1 (GND), U11.3 (FRS), U11.4 (DIR), U11.5 (DSC), U11.14 (VOV), U11.15 (GND), U12.1 (GND), U12.3 (FRS), U12.4 (DIR), U12.5 (DSC), U12.14 (VOV), U12.15 (GND); also elsewhere on the board
unnamed: R39.1, U11.2 (EN)
unnamed: R40.1, U11.13 (ISEN)
unnamed: R45.1, U12.2 (EN)
unnamed: R46.1, U12.13 (ISEN)

Notes on the sheet:
Trickle resistor allows small continuity current bypass
Charge present bypasses continuity divider

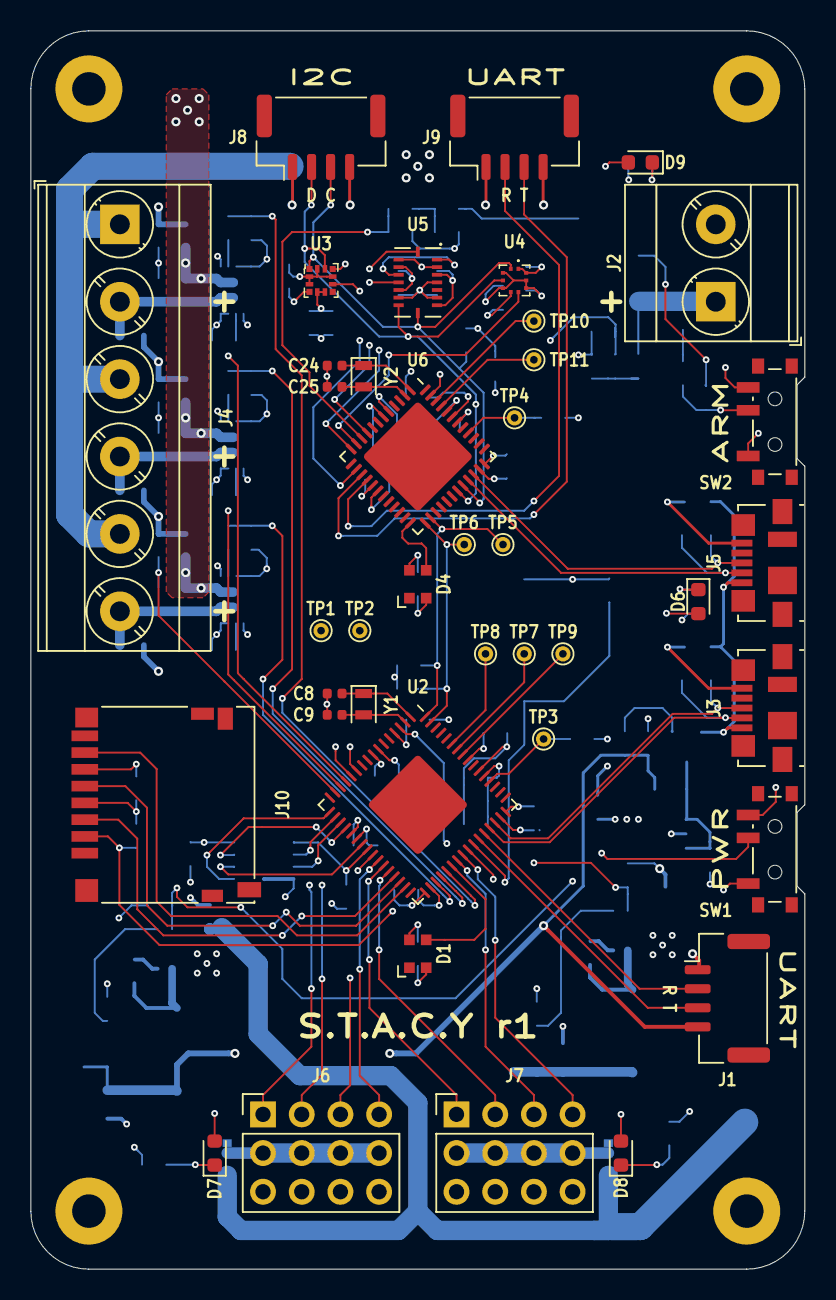
[picture p60: board allfc.kicad_pcb from above]

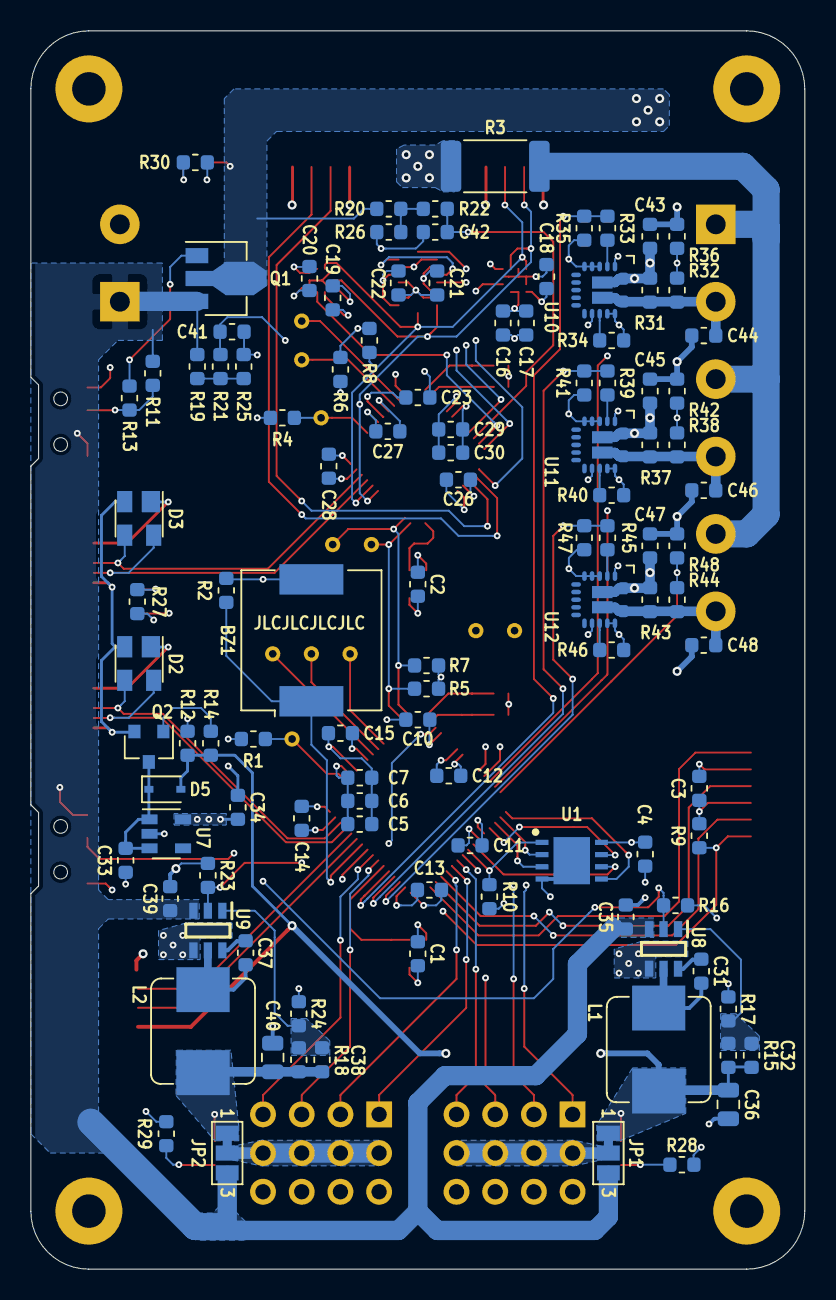
[picture p61: board allfc.kicad_pcb from below]

Board: 4 copper layers, 50.8 x 81.3 mm, 153 parts (109 on the bottom side), 97 nets.
