peregrine-developments/STACY/piggyboard/piggy/piggy.kicad_pcb

## KiCad design piggyboard/piggy/piggy.kicad_pcb (2021-08-03)

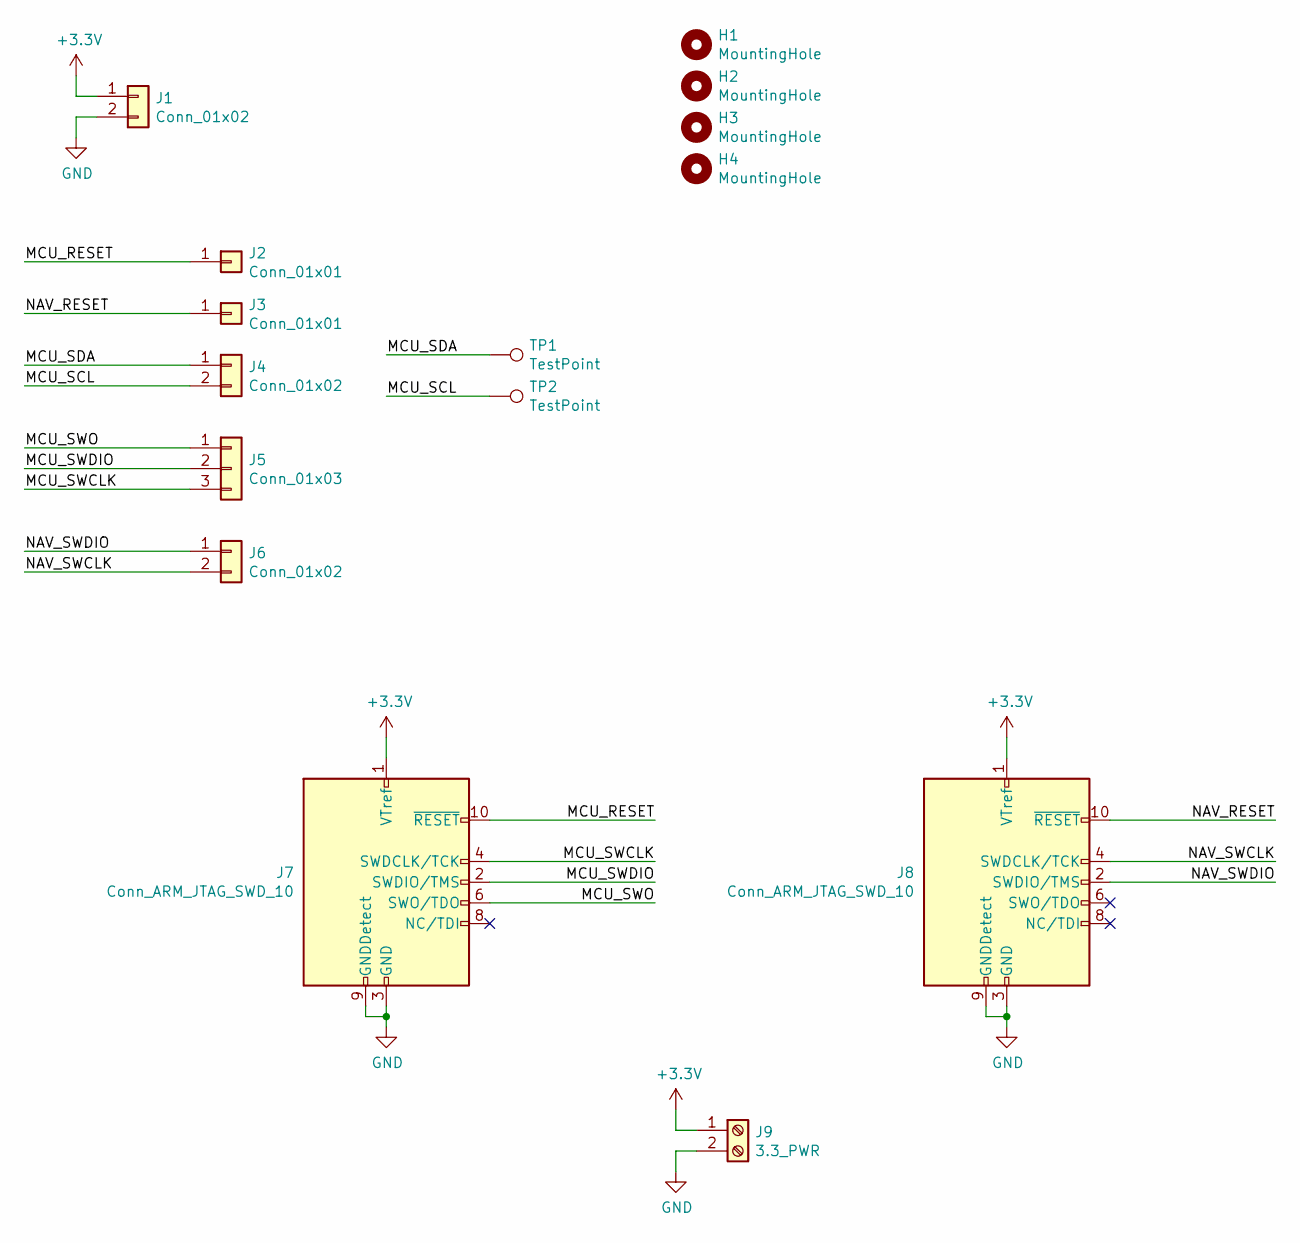
[picture p62: schematic piggy.sch]

Parts:
H1, H2, H3, H4: MountingHole; MountingHole_2.2mm_M2_Pad
J1, J4, J6: Conn_01x02; PinHeader_1x02_P2.54mm_Vertical
J2, J3: Conn_01x01; PinHeader_1x01_P2.54mm_Vertical
J5: Conn_01x03; PinHeader_1x03_P2.54mm_Vertical
J7, J8: Conn_ARM_JTAG_SWD_10; PinHeader_2x05_P1.27mm_Vertical_SMD
J9: 3.3_PWR; TerminalBlock_Phoenix_MKDS-3-2-5.08_1x02_P5.08mm_Horizontal
TP1, TP2: TestPoint; TestPoint_Bridge_Pitch2.54mm_Drill1.0mm

Connections:
+3V3: J1.1, J7.1 (VTref), J8.1 (VTref), J9.1
/MCU_RESET: J2.1, J7.10 (~RESET~)
/MCU_SCL: J4.2, TP2.1
/MCU_SDA: J4.1, TP1.1
/MCU_SWCLK: J5.3, J7.4 (SWDCLK/TCK)
/MCU_SWDIO: J5.2, J7.2 (SWDIO/TMS)
/MCU_SWO: J5.1, J7.6 (SWO/TDO)
/NAV_RESET: J3.1, J8.10 (~RESET~)
/NAV_SWCLK: J6.2, J8.4 (SWDCLK/TCK)
/NAV_SWDIO: J6.1, J8.2 (SWDIO/TMS)
GND: J1.2, J7.3 (GND), J7.5 (GND), J7.9 (GNDDetect), J8.3 (GND), J8.5 (GND), J8.9 (GNDDetect), J9.2

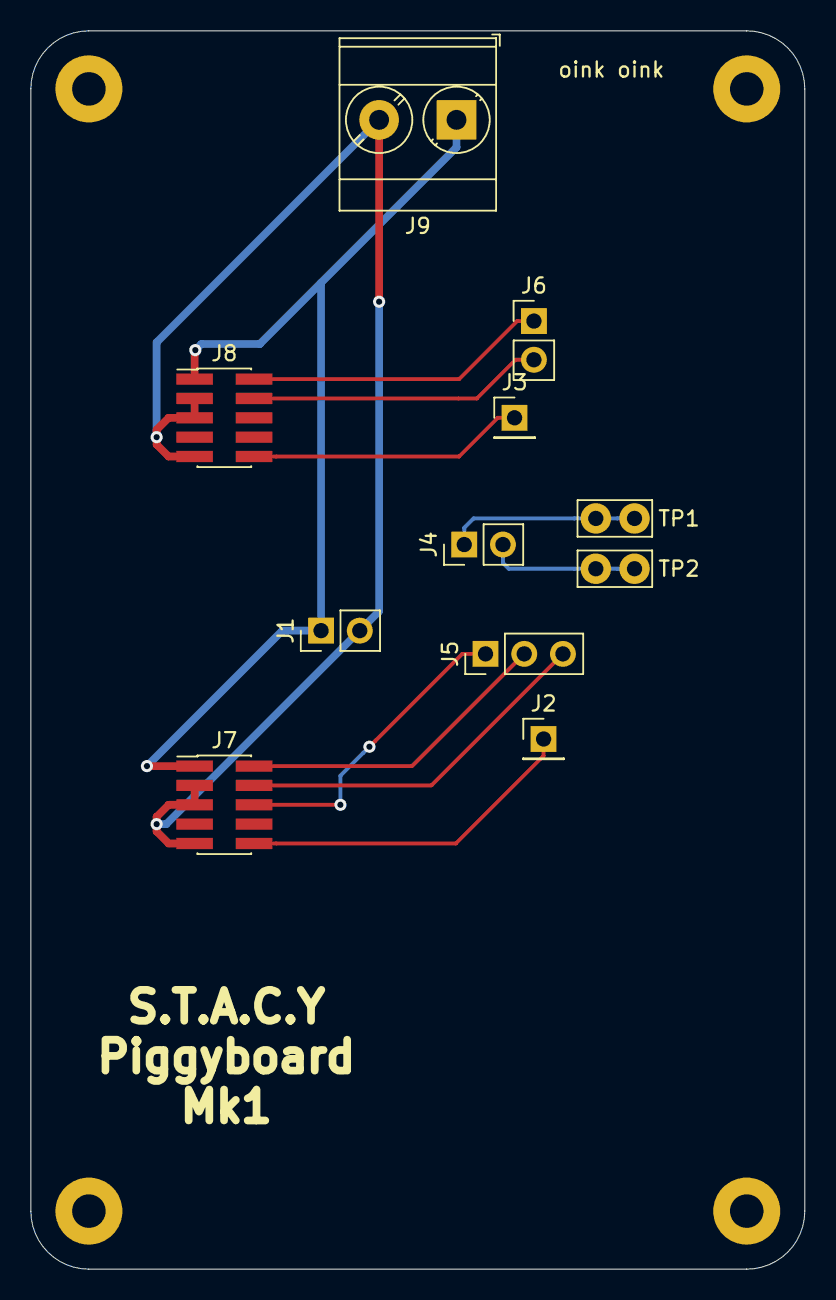
[picture p63: board piggy.kicad_pcb from above]

Board: 2 copper layers, 50.8 x 81.3 mm, 15 parts (0 on the bottom side), 11 nets.
