peregrine-developments/STACY/(commit log)

2021-08-03 initial upload
    [allfc-B_Cu.gbl, allfc-B_Mask.gbs, allfc-B_Paste.gbp, allfc-B_SilkS.gbo, allfc-Edge_Cuts.gm1, allfc-F_Cu.gtl, allfc-F_Mask.gts, allfc-F_Paste.gtp]
2021-08-03 release 1 schematic pdf
2022-02-06 Mount 3D Files
    [Base Mount.3mf, Battery Mount.3mf, Bulkhead Mount.3mf, GPS Mount.3mf, main.sch]
